glascurain4/Valeo-ULS-Simulation/(list of files, drawings)

Other design files:
Hardware/valeo3.pdsprj
Microcontroller/ExpPuertos.DSN
Microcontroller/ExpPuertos.pdsprj
